beneater/eeprom-programmer/(threads)

Thread 2 (2017-04-12):

Need correction to Diagram - Some Pin connections are incorrect.

space1649, 2017-04-12:
D2 D3 and D4 should be connected to Pin 14, Pin(s) 11, Pin(s) 12 respectfully.
Here is a corrected diagram.
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

martinKindall, 2017-04-26:
Thanks for pointing this out, I used this correction and my circuit worked!
I used a 28C16, I did some modificacion to match the pins from A0 to A10 (28C16 doesnt have A11-A14) and WE, OE and CS.

ChrisOMills, 2017-06-16:
Thanks! this helped me out a lot!

Closed 2017-06-23.

Thread 5 (2018-01-21):

at28c256 write protection

DavideRuzza, 2018-01-21:
hi. i have a problem to program the at28c256 eeprom. with the at28c16 works perfectly . I have read in its datasheet that there is a write protection to unlock with a sequence of byte in some registers.
I have tried to write this sequence with the library write function, but it did't work

levvayner, 2018-04-22:
Hi David, I am having the same problem with a different set of code and differently built programmer. I bought some AT28C256 on eBay, and spent a long time trying to figure out what was wrong with my code/wiring. Long story short, your problem might be the same. If no matter what you do, you are getting 0xFF back, you might not have genuine ATMEL AT28C256 chips, rather something that was "rebranded" in China, even though I bought mine from a U.S. seller.

More here http://stardot.org.uk/forums/viewtopic.php?t=11039

MeadeRobert, 2018-05-18:
So... if the chips aren't genuine... we're out of luck? I bought 5 from jameco and 2 from amazon. I can't get any of them to program. I just went out of my way and bought and EEPROM programmer from amazon. I'll let you know if its chips or this setup.

DavideRuzza, 2018-06-04:
Sorry if i haven't reply. I have to say that i managed in some way to make
it work but only for a few times. With the code of Ben Eater's programmer i
manually set the addresses like the datasheet said to remove write
protection. I was surprised but it worked, infact i programmed it a few
times. Than i removed the chip from the prototype board where i built my
diy programmer to see the data from another circuit. When i put the chip
again in the programmer it had not worked anymore and i gave up. I buoght
the atmel28c16 which worked perfectly but i had to renounce to all that
storage size that the Atmel 256 offers

2018-05-18 10:35 GMT+02:00 Robert Meade <notifications@github.com>:

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

levvayner, 2018-09-19:
Wanted to give you guys an update. I bought a TL866 II Plus programmer, and it worked! Once I used it to set flags to disable write protect and not re-enable it, I could use my own programmer just fine. Lost at least 20 hours to that battle, although still not sure what has to be done differently. I used the datasheet and it does not unblock it. I could hook up an oscilloscope and try to check it out, but probably wont.

Thread 7 (2018-09-18):

Lack of indirect memmory access implies need of self-modyfing code (to be Turing-complete)

hadrava, 2018-09-18:
Sorry if this issue is in wrong place. I cannot find a project about 8-bit computer. But it is still about the data that are written to EEPROM.

---

With current microcode, the memory address register can be set only by address hard-coded in instruction operand. It is now difficult* to write code that access an array element:

*) by difficult i mean that you have to use self-modifying code, which is non-standard construction

C example:
```c
uint8_t array[4] = {10, 11, 12, 13};
uint8_t index = 2;
uint8_t c;

c = array[index];
```
Assembly representation:
```asm
0: LDA 0xE ; load variable index to register A
1: ADD 0x9 ; add op-code of instruction which loads first element of an array
2: STA 0x3 ; modify next instruction so it will load data from array[index] instead of array[0]
3: LDA 0xA ; this is modified to LDA 0xC (A <-- array[index]) before running
4: STA 0xF ; save result to variable c
5: HLT;
6:
7:
8:
9: LDA 0xA ; instruction which would load array[0], used for indirect access
A: 10 ; array[0]
B: 11 ; array[1]
C: 12 ; array[2]
D: 13 ; array[3]
E:  2 ; index
F:  0 ; c (the result)
```

"Usual" instruction sets would be Turing-complete even if we disallow self-modifying code (e. g. forbid writes to code segment of memory). In fact, this is quite common: In "normal" computers, the program is run from RAM. But it is usually in write-protected segments and data segments are protected from execution. It is not that common for code to self-modify itself. Same applies also to theoretical models. Neither Turing Machine nor Random Access Machine can modify its own code. But both are Turing-complete.

On the other hand, the Turing completeness of your 8-bit computer instruction set relies on ability of code to self-modify. Without self-modifying code, it can access only constant size of memory. So it cannot do anything like loop through an input array. In that case this 8-bit computer would not be Turing-complete anymore.

It basically means, that it is Turing-complete, but in different way than "normal" computers. I know, that you want to keep your 8-bit computer as simple as possible, but for educational purpose this difference should be at least noted somewhere.

If i may use analogy with Turing Machine from your video "Making a computer Turing complete". Turing machine's new state depends on data, so we need conditional jump. And same apply to memory address: Turing machine's next memory address (head position) also depends on data, so we need to set memory register based on data and not just to position fixed by a code.

And yes, current implementation overcomes lack of indirect access with self-modifying code. That is something that Turing Machine or Random Access Machine cannot do -- both models cannot modify their code, so they both need some kind of indirect access.

I suggest to add a pair of instructions which would do indirect load/store operations. Load is quite simple to implement: we can define LDAX instruction which will load data from address stored in register A:

```c
 { MI|CO,  RO|II|CE,  AO|MI,  RO|AI,  0,           0, 0, 0 },   // 1001 - LDAX
```

But there are few issues with store. There is no instruction to manipulate with B register directly, so instruction that would save A to address stored in B would be useless. (Unless something like `MOV A -> B` is also added.)

So second option is to have indirect instructions LDAI/STAI load/store from/to address stored in memory address specified with operand.

```c
 { MI|CO,  RO|II|CE,  IO|MI,  RO|BI,  BO|MI,   RO|AI, 0, 0 },   // 1001 - LDAI
 { MI|CO,  RO|II|CE,  IO|MI,  RO|BI,  BO|MI,   AO|RI, 0, 0 },   // 1001 - STAI
```
Only problem is, that these instructions are too long: 6 steps. But maybe it is possible to write directly from RAM register to Memory register (i am not sure about buffering there):
```c
 { MI|CO,  RO|II|CE,  IO|MI,  RO|MI,   RO|AI, 0, 0, 0 },   // 1001 - LDAI
 { MI|CO,  RO|II|CE,  IO|MI,  RO|MI,   AO|RI, 0, 0, 0 },   // 1001 - STAI
```
After that, the example from beginning can be written without code modification:

```asm
0: LDA  0xE ; load variable index to register A
1: ADD  0xA ; add address of first element of an array
2: STA  0x9 ; save pointer *array[index] to temporary variable
3: LDAI 0x9 ; indirect load
4: STA  0xF ; save result to variable c
5: HLT;
6:
7:
8:
9:  0 ; temporary variable used to overcame lack of address registers
A: 10 ; array[0]
B: 11 ; array[1]
C: 12 ; array[2]
D: 13 ; array[3]
E:  2 ; index
F:  0 ; c (the result)
```

---

Well. What i just wrote is not entirely true. Turing Machine may be still simulated even if we do not have indirect access and we forbid self modifications of code. But we would need to extend word size to incredible lengths and store whole array in just one word. Than something as indirect access can be simulated using bit shifts and masking. So it can be computed with current instructions without self-modification. But that would be even bigger hack, which is usually forbidden even in theoretical models like Random Access machine.

Thread 9 (2020-02-13):

28c256 infinite loop while erasing

Cubzer, 2020-02-13:
I modified the code so that it would overwrite the whole chip with 0xea. Turns out when i change the break condition in the erase loop to 32767 to match the size of the eeprom it goes into a seemingly infinite loop. My guess is that the 16 bit signed INT of the arduino overflows so that the break condition of the erase loop will never be met. Changing this to an unsigned INT solved the problem for me. But because of my inexperience with arduinos i could also be wrong.

GregEakin, 2020-08-09:
Yes. The int variable `address` is a [signed 16-bit variable](https://www.arduino.cc/reference/en/language/variables/data-types/int/). That means it'll never be larger than 32,767. Instead, it'll wrap around to -32,768 and start over again. We can change the `address` variable to a `long` type:
```
  // Erase entire EEPROM
  Serial.print("Erasing EEPROM");
  for (long address = 0L; address <= 0x7FFFL; address += 1L) {
    writeEEPROM((int)address, 0xff);

    if (address % 64 == 0) {
      Serial.print(".");
    }
  }
  Serial.println(" done");
```
As long as we don't send the `writeEEPROM(int address, byte data)` method an address with more than 15 bits.

Thread 10 (2020-05-02):

Repeating last byte for all addresses

8BitMark, 2020-05-02:
I'm having some difficulty with writing to the 256 eeprom.  If I link pin 8 of the 74HC595 to GND the eeprom erases but won't write the test data.  When I remove these the correct number of test bytes are written but they are all set to the value of the last byte of the test string.  Any help would be appreciated.

TnnsBeast, 2023-01-01:
I am having this issue as well, did you manage to fix it?

Thread 11 (2020-06-06):

Write protected EEPROMS from China

Sakvojage, 2020-06-06:
Hi,
I've received several EEPROMs from Ebay, but I'm only able to program one of seven AT28C256.
Of course these are weird fakes or old dead ones, but I have tried to software erase those or disable protection. No luck yet. Am I doing it right?

Docs:
CHIP erase - http://ww1.microchip.com/downloads/en/Appnotes/doc0544.pdf
Protection - http://ww1.microchip.com/downloads/en/Appnotes/DOC0543.PDF

 ```
unsigned long time;
void setup() {
  pinMode(SHIFT_DATA, OUTPUT);
  pinMode(SHIFT_CLK, OUTPUT);
  pinMode(SHIFT_LATCH, OUTPUT);
  digitalWrite(WRITE_EN, HIGH);
  pinMode(WRITE_EN, OUTPUT);
  Serial.begin(230400);

  Serial.print("\nUnlocking EEPROM... ");
  time = millis();
  writeEEPROM(21845, 0xaa);
  writeEEPROM(10922, 0x55);
  writeEEPROM(21845, 0x80);

  writeEEPROM(21845, 0xaa);
  writeEEPROM(10922, 0x55);
  writeEEPROM(21845, 0x10);

  writeEEPROM(1, 0x55);
  writeEEPROM(2, 0xaa);
  writeEEPROM(32767, 0x55);

  time = millis() - time;
  Serial.print("...done in ");
  Serial.println(time);

  printContents();
  writeEEPROM(1, 0x55);
}
```

It finished in 12 ms as I have reduced WRITE_EN cycle:

```
 digitalWrite(WRITE_EN, LOW);
  delayMicroseconds(1);
  digitalWrite(WRITE_EN, HIGH);
  delay(1);
```

Any thoughts?

GregEakin, 2020-08-09:
Have you tried disabling the write-protect?
```
unsigned long time;
void setup() {
 pinMode(SHIFT_DATA, OUTPUT);
 pinMode(SHIFT_CLK, OUTPUT);
 pinMode(SHIFT_LATCH, OUTPUT);
 digitalWrite(WRITE_EN, HIGH);
 pinMode(WRITE_EN, OUTPUT);
 Serial.begin(230400);

 Serial.print("\nUnlocking EEPROM... ");
 time = millis();

 // three-write command prefix
 writeEEPROM(0x5555, 0xAA);
 writeEEPROM(0x2AAA, 0x55);
 writeEEPROM(0x5555, 0x80);

 // three-write command to disable protection
 writeEEPROM(0x5555, 0xAA);
 writeEEPROM(0x2AAA, 0x55);
 writeEEPROM(0x5555, 0x20);

 delay(20) // tWC - wait for the EEPROM to finish

 // Write new data to the EEPROM
 writeEEPROM(0x0001, 0x55);
 writeEEPROM(0x0002, 0xAA);
 writeEEPROM(0x7FFF, 0x55);

 time = millis() - time;
 Serial.print("...done in ");
 Serial.println(time);

 Serial.println("Reading EEPROM");
 printContents();
}
```

Thread 16 (2021-10-03):

Ben Eater  arduino programer.  First 16  bytes do not erase

RichIsAvailable, 2021-10-03:
Hi Ben and everyone. I am enjoying this fun project, on my way to build the 65 bread board computer.  This issue is
Your code will erase the EEPROM, but it will not touch the first 16 bytes.  My EEPROM is  a AT28C64B

ElectroBoy404NotFound, 2022-02-07:
For me, it does not even touch the EEPROM

Thread 18 (2022-01-17):

DS1642 can be supported?

rtek1000, 2022-01-17:
Hello,

Can NV RAM with built-in RTC model DS1642 be supported by this programmer?

As I understand it, this is an NV RAM that has RTC built in, but the operation is similar to a regular parallel NV RAM.

Parallel EEPROM memory has similar read and write commands.

Datasheet: https://datasheets.maximintegrated.com/en/ds/DS1642.pdf

Thank you.

rtek1000, 2022-01-17:
In case anyone needs such a memory, I found this other compatible code: M48T02/12:

https://www.st.com/en/clocks-and-timers/m48t12.html

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

rtek1000, 2022-01-26:
This DS1642 memory can be read and written by TL866II Plus grader, just select M48T12 memory (I asked developer to add DS1642 too, new xgpro software version released, not tested yet).

In the TL866II Plus, it is necessary to operate the write bit of the DS1642 to be able to write the clock addresses.

The DS1642 (or M48T02 or M48T12) has an internal oscillator that can be calibrated, so a 512Hz frequency measurement service is required.

It also has a read bit, which helps to prevent the read from being done when updating the clock addresses.

These details are all in the datasheet.

rtek1000, 2022-01-26:
> For more information on calibration, see the application note AN924, “TIMEKEEPER®
> calibration.”

https://www.st.com/resource/en/application_note/an934-how-to-use-the-digital-calibration-feature-in-timekeeper-and-serial--realtime-clock-rtc-products-stmicroelectro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

rtek1000, 2022-01-28:
I found a library that seems to have good accuracy for measuring low frequencies using Arduino, maybe this library can be used to calibrate in a basic way at least:

https://github.com/PaulStoffregen/FreqMeasure/issues/22

rtek1000, 2022-01-29:
I managed to test the memory (but the calibration must need more precision equipment, the reading was fluctuating in the thousandths of a Hz, 24MHz sampling).

Need to write these addresses before testing:

- **Address 7F8: 0x80** (WRITE bit: Enables writing of RTC addresses - Set to '0' for normal clock operation)
- **Address 7FC: 0x40** (FREQUENCY TEST bit - Set to '0' for normal clock operation)

I needed to leave the address and control pins with this configuration in the image below, in case anyone wants to test it someday. (VCC: +5V; VSS: GND or 0V)

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

It is important to be aware of this (strange) information that is in the datasheet:

- **Setting or changing the calibration byte does not affect the frequency test output frequency.**

Unfortunately I came to the conclusion that the Saleae Logic software (with 8-channel logical analyzer) seems to be better than the Sigrok software (with 16-channel logical analyzer). Both analyzers with CY7C68013A I.C., the difference is that the 8-channel analyzer has a buffer, but I don't know if this can affect the reading that much.

8 ch type:
https://atadiat.com/en/e-hands-on-test-saleae-usb-logic-analyzer-24mhz-8ch-clone/

16 ch type:
https://forum.hobbycomponents.com/viewtopic.php?t=1891

Thread 20 (2022-04-04):

Question on the delay of 10 ms when writing to the EEPROM

ralphtheninja, 2022-04-04:
In the video where you go through how to build an EEPROM programmer with the Arduino Uno you ended up using `delay(10);` at the end of the `writeEEPROM()` function. Did you come to any understanding why this was the case?

What if you want to write all the 2048 bytes, then it would take almost 20 seconds and it would be even worse for an EEPROM with 128 or 256 kbits.

Would it be possible to optimize the `writeEEPROM()` function to let it take an array of bytes and put the `delay(10)` at the end of writing _all_ the bytes?

greenonline, 2023-04-27:
This issue is partially answered/explained by [this comment](https://www.youtube.com/watch?v=K88pgWhEb1M&lc=UgxBex7zEAhDhbuNuIN4AaABAg) under the video:

> Hi Ben. Good educational stuff. But just thought I’d point out that the issue you saw with your incorrect read following write, is because you didn’t implement the (not)DATA POLLING, outlined in the 28C16 data sheet.
ie. "The AT28C16 provides DATA POLLING to signal the completion of a write cycle.”
DATA POLLING uses the inversion of the most significant bit (when a post write read is performed) to indicate the write busy state. Please also note that the other read bits (other than MSB), are indeterminate during the data polling busy state.
So when you saw two subsequent reads of 0x81 after writing 0x2A, you’ll note the byte you wrote (0x2A) has a 0 MSB, and the read value (0x81) has a 1 MSB (ie. inverted 0 indicating busy state). The remaining bits of the 0x81 byte being indeterminate.
By the third byte read, the busy state was complete, and the 3rd address data byte, and onwards, were then correctly retrieved.
Likewise, the same can be seen with your second attempt to write 0x00, where you then read 0xAA bytes.  Again, note the MSB is inverted from 0 to 1, to indicate data polling busy state.
In summary: Although the Write Cycle Time is spec’d as max 1ms, you really shouldn’t just assume a 1ms delay will do the trick. The correct implementation would be to perform a read loop after a write, to poll for a non inverted MSB of the byte just written, to await busy state completion.

Thread 21 (2023-01-24):

Read/Write to 0x8000-0xFFFF may cause damage to the chip

ultrasuperpingu, 2023-01-24:
I'm not totally sure but my AT28C256 seems damaged. Adresses 0x7FE0 and 0x7FF0 returns 00 and when writting to them, the value is written to the next byte (respectively 0x7FE1 and 0x7FF1), and the same for 0x7FE2-0x7FEE and 0x7FF2-0x7FFE. Write 0x7FEF and 0x7FFF does nothing. I first though my wiring had an issue but everything seems fine when I read/write in 0X0000-0x7FDF so I guess my eeprom is damaged.

I guess that I damaged it trying to write at adresses > 0x7FFF because the Output Enable pin is then true whatever the outputEnable parameter is (I did that by mistake with a copy/paste of a write loop with `base<=xxx` where I replaced xxx by 32768). I think a simple `address&=0x7FFF;` at the beginning of the `setAdress` function would be more secure.
But again, not sure it was the problem but the fix is safe...

Thread 22 (2023-09-17):

Typo in schematics (74HC595 pinout)

airplaneboat, 2023-09-17:
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

Pin 13 on the 74HC595 chips (the output enable pin, OE) is labeled as "G", and pin 8 (the ground pin, GND) is not labeled.
Both Pin 8 (GND) and Pin 13 (OE) need to be tied to ground for this design to work properly.

I saw "G" tied to ground and assumed that was referring to ground, and didn't give it a second thought. a couple hours later with the oscilloscope I finally figured out why it wasn't working for me- my OE pins were floating because I wasn't paying attention.

It's my own fault for not paying attention, but I'm submitting this just incase someone else has the same issue.

SnappyRiffs, 2024-12-06:
U3 and U4 does not appear to have vcc and ground, could be an issue with kicad. "G" refers to OE yes, and I think it is just the fact that different IC manufacturers use different symbols (TI uses /OE)
